yanataka60/TK-80BS_SD/JPEG/PIN1.JPG

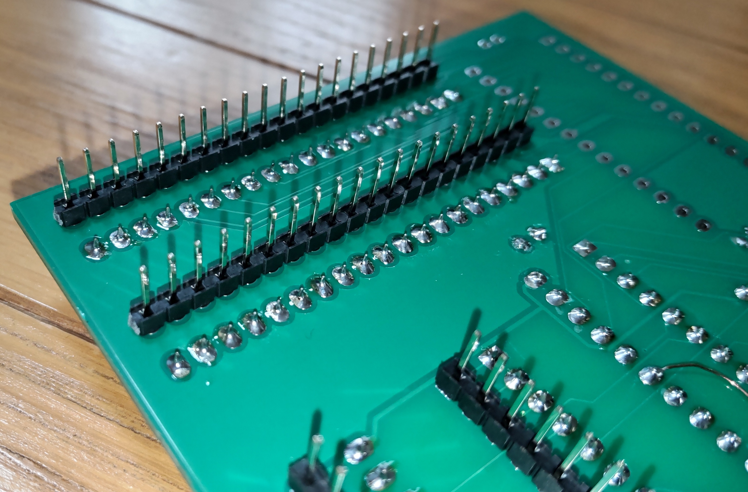
JPEG/PIN1.JPG
