yanataka60/TK-80BS_SD/JPEG/PIN2.JPG

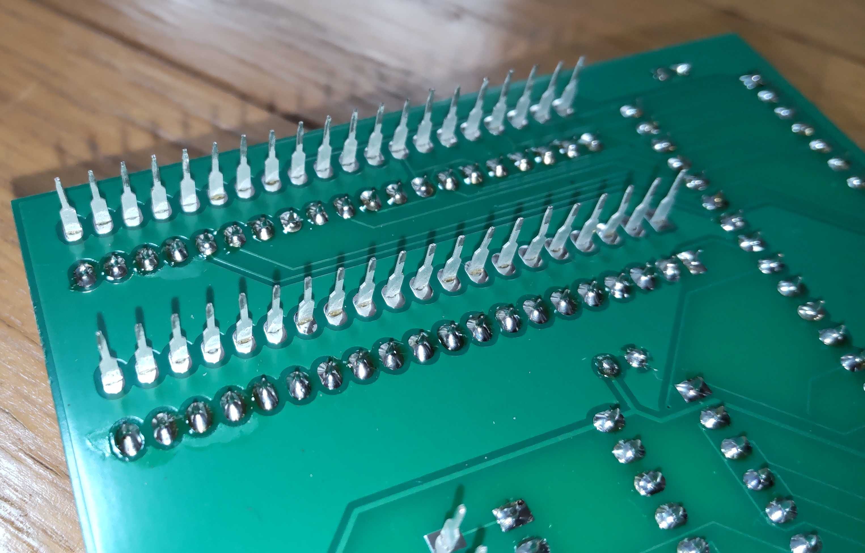
JPEG/PIN2.JPG
