yanataka60/TK-80BS_SD/JPEG/ROM2732.JPG

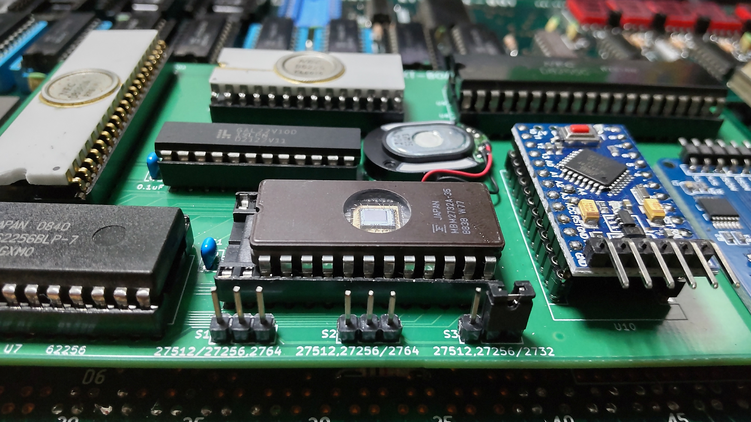
JPEG/ROM2732.JPG
