yanataka60/TK-80BS_SD/JPEG/ROM2764.JPG

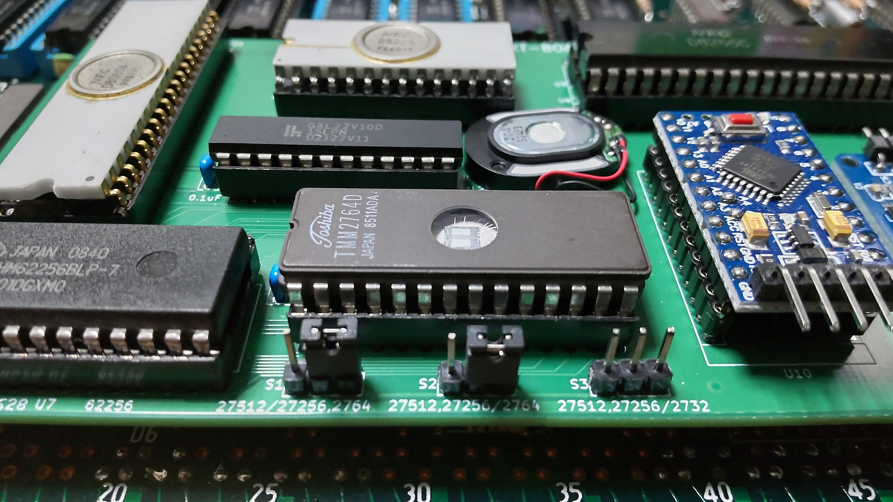
JPEG/ROM2764.JPG
