yanataka60/TK-80BS_SD/JPEG/ROM27256.JPG

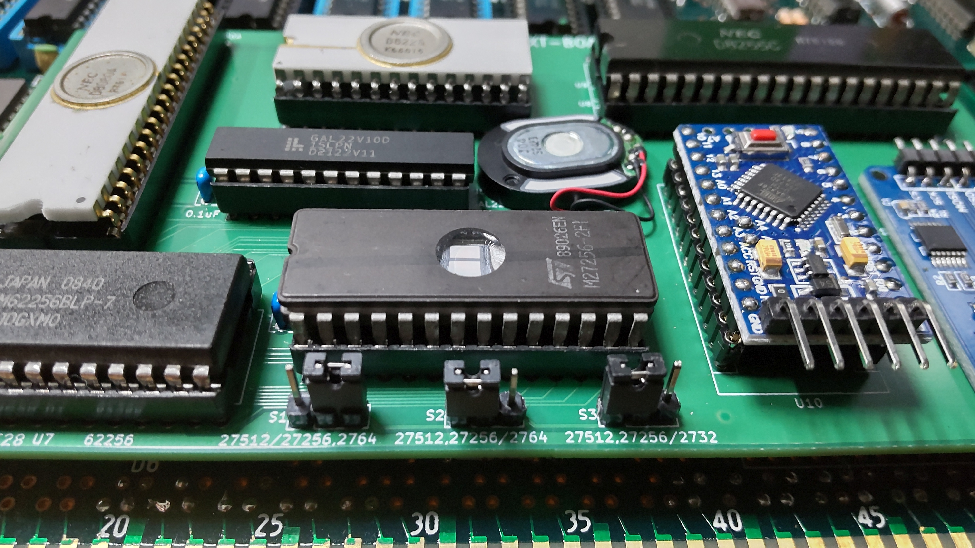
JPEG/ROM27256.JPG
