yanataka60/TK-80BS_SD/JPEG/TK-80_EXT-BOARD.JPG

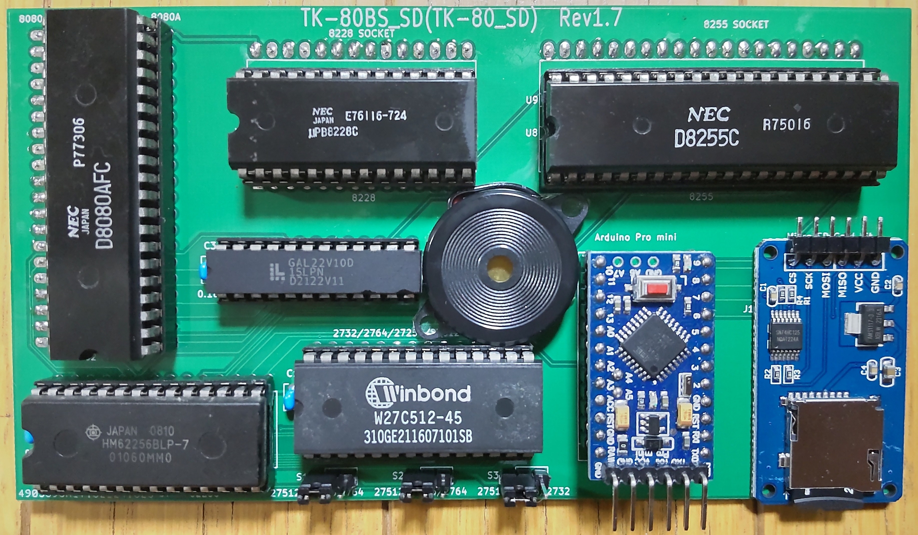
JPEG/TK-80_EXT-BOARD.JPG
