yanataka60/TK-80BS_SD/JPEG/TK-80BS_SD.JPG

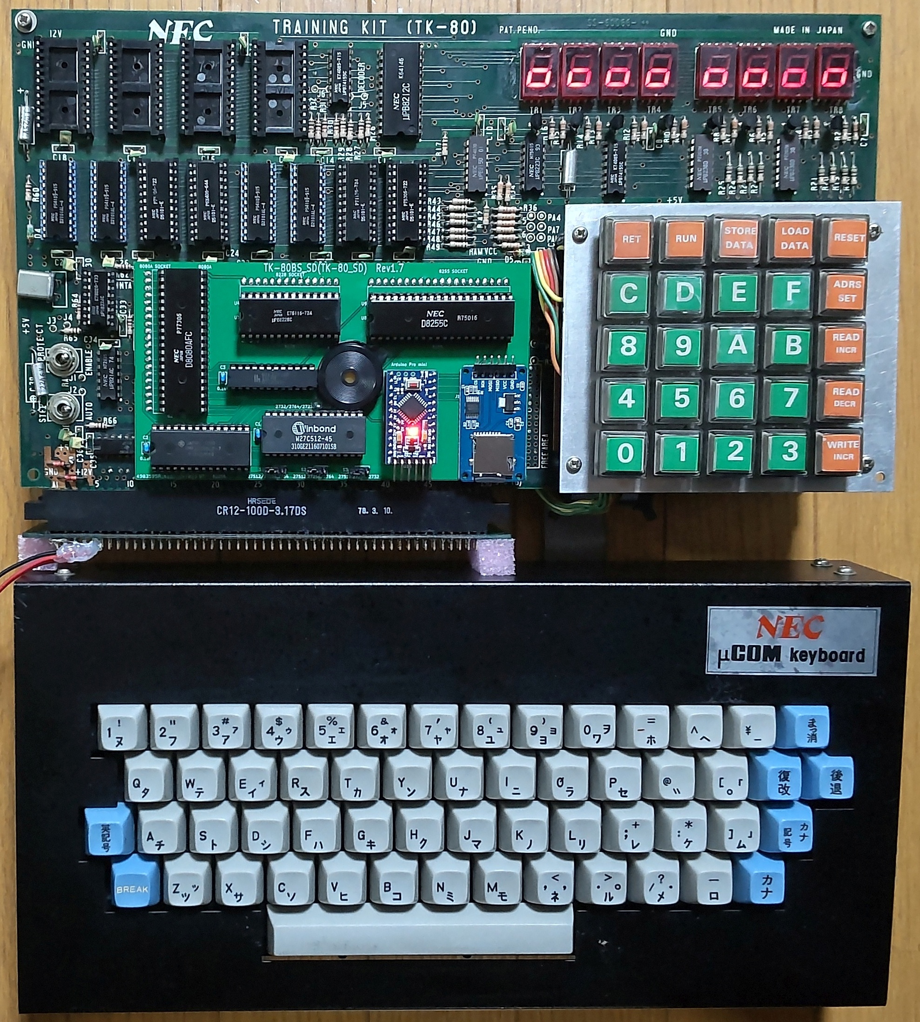
JPEG/TK-80BS_SD.JPG
