yanataka60/TK-80BS_SD/KiCad/TK-80_EXT-BOARD.pdf

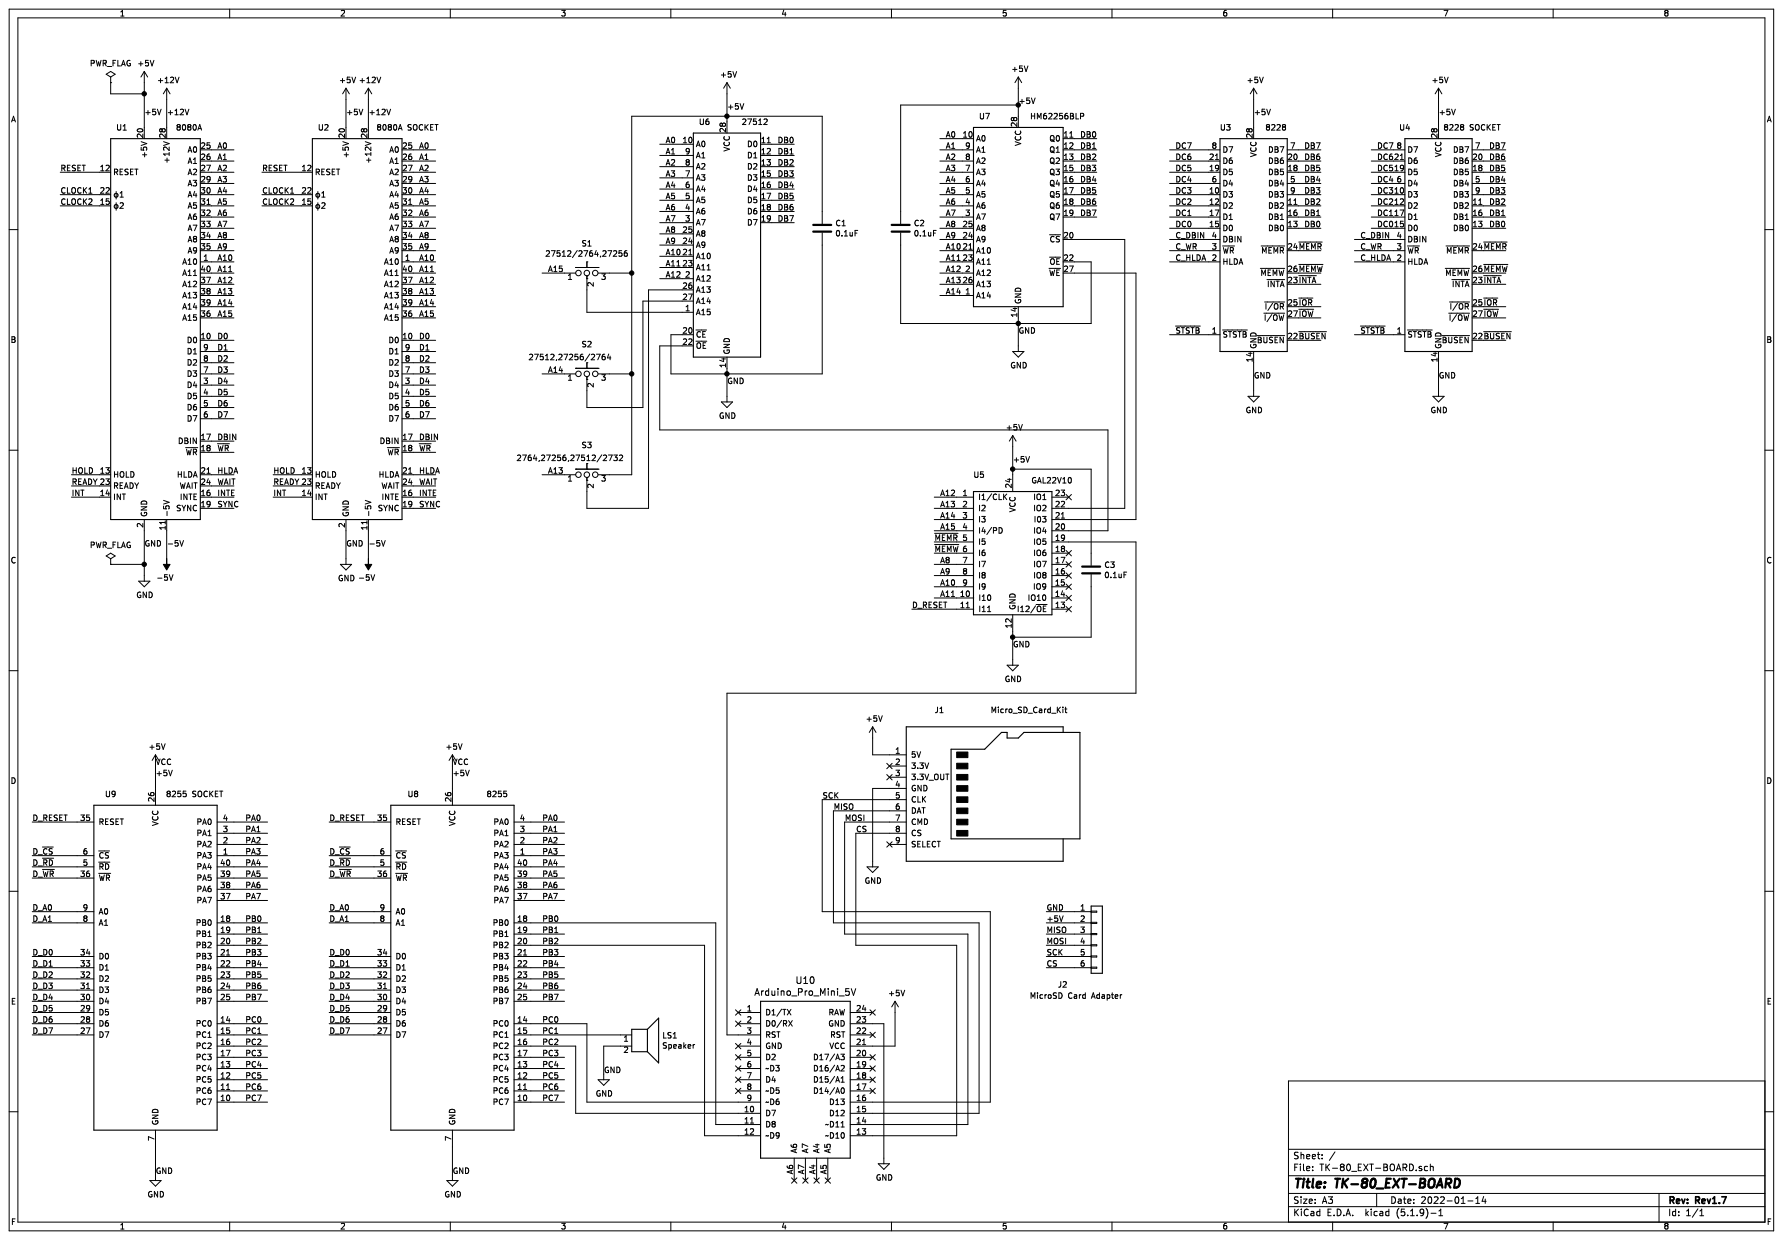
[picture p14: page 1]
