yanataka60/TK-80BS_SD/(list of files, drawings)

Other design files:
KiCad/TK-80_EXT-BOARD.dsn
