yanataka60/TK-80BS_SD/KiCad/TK-80_EXT-BOARD.kicad_pcb

## KiCad design KiCad/TK-80_EXT-BOARD.kicad_pcb (2024-10-25)

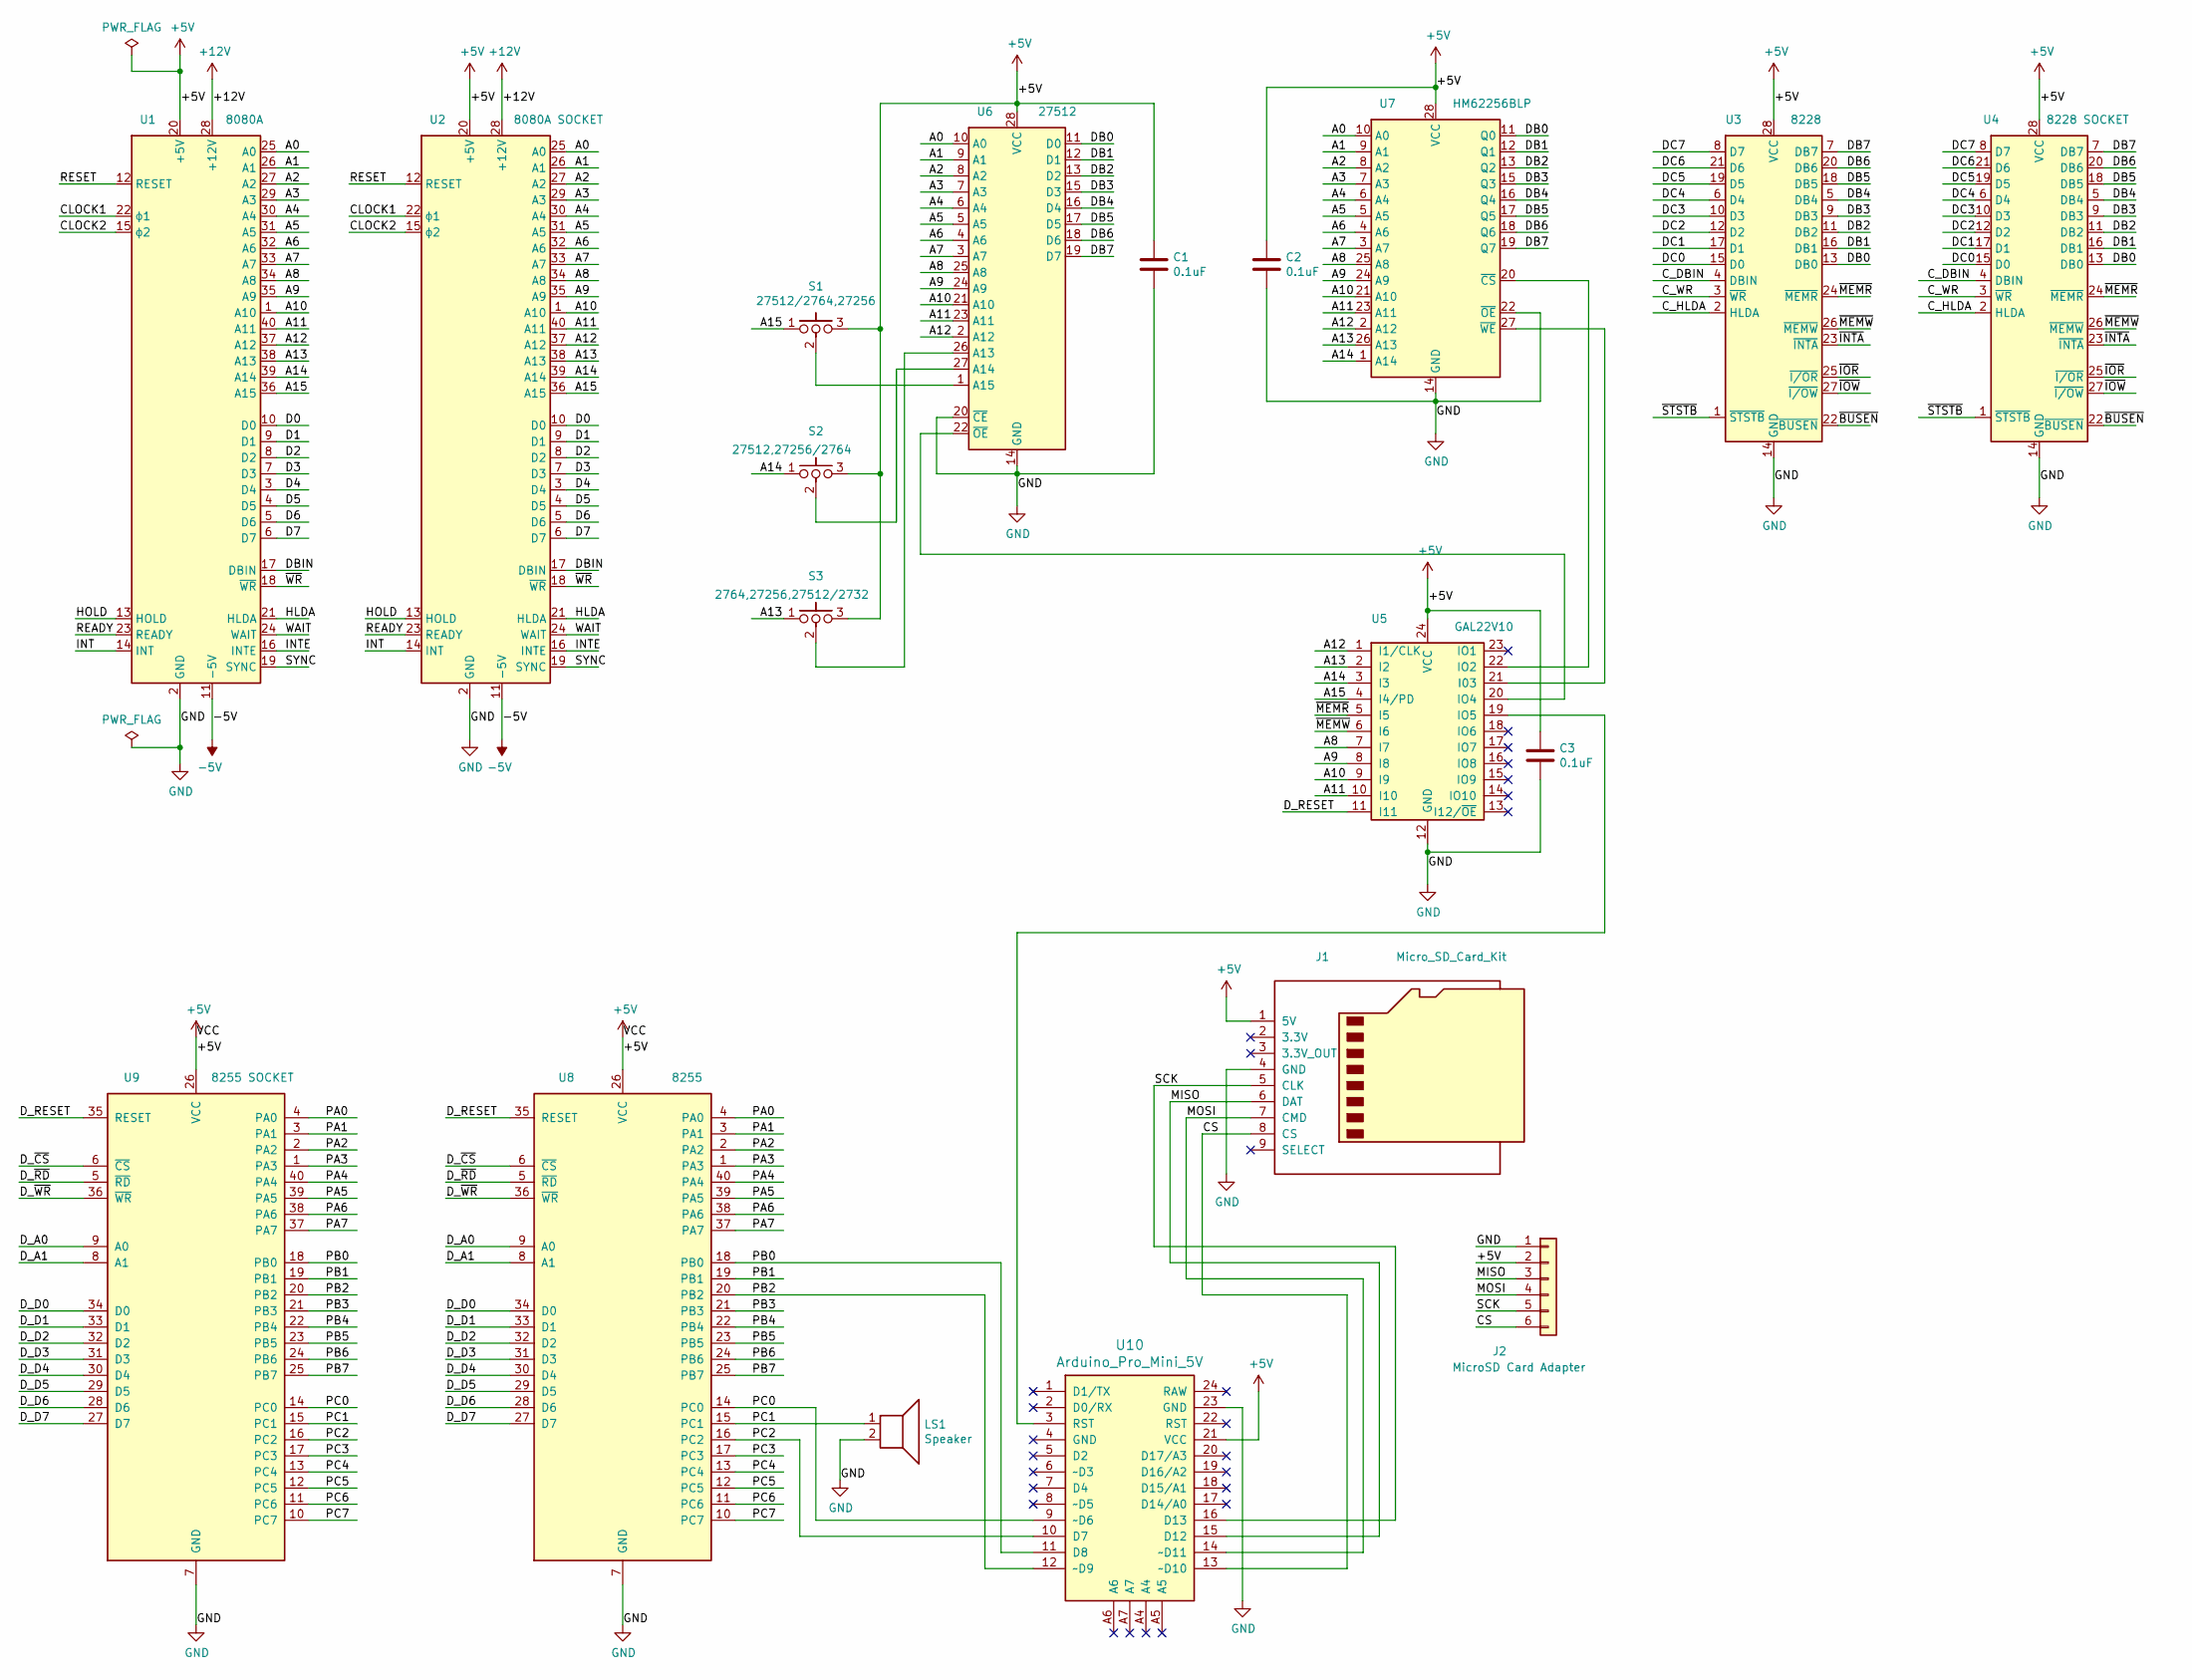
[picture p15: schematic TK-80_EXT-BOARD.sch]

Parts:
C1, C2, C3: 0.1uF; C_Rect_L4.0mm_W2.5mm_P2.50mm
J1: Micro_SD_Card_Kit; AE-microSD-LLCNV
J2: MicroSD Card Adapter; PinSocket_1x06_P2.54mm_Vertical
LS1: Speaker; PinHeader_1x02_P2.54mm_Vertical
S1: 27512/2764,27256; PinHeader_1x03_P2.54mm_Vertical
S2: 27512,27256/2764; PinHeader_1x03_P2.54mm_Vertical
S3: 2764,27256,27512/2732; PinHeader_1x03_P2.54mm_Vertical
U1: 8080A; DIP-40_W15.24mm_LongPads
U2: 8080A SOCKET; DIP-40_W15.24mm_LongPads
U3: 8228; DIP-28_W15.24mm_LongPads
U4: 8228 SOCKET; DIP-28_W15.24mm_LongPads
U5: GAL22V10; DIP-24_W7.62mm_LongPads
U6: 27512; DIP-28_W15.24mm_LongPads
U7: HM62256BLP; DIP-28_W15.24mm_LongPads
U8: 8255; DIP-40_W15.24mm_LongPads
U9: 8255 SOCKET; DIP-40_W15.24mm_LongPads
U10: Arduino_Pro_Mini_5V; Arduino_Pro_Mini

Connections:
+5V: C1.1, C2.1, C3.1, J1.1 (5V), J2.2, S1.3, S2.3, S3.3, U1.20 (+5V), U2.20 (+5V), U3.28 (VCC), U4.28 (VCC), U5.24 (VCC), U6.28 (VCC), U7.28 (VCC), U8.26 (VCC), U9.26 (VCC), U10.21 (VCC)
+12V: U1.28 (+12V), U2.28 (+12V)
-5V: U1.11 (-5V), U2.11 (-5V)
/A0: U1.25 (A0), U2.25 (A0), U6.10 (A0), U7.10 (A0)
/A1: U1.26 (A1), U2.26 (A1), U6.9 (A1), U7.9 (A1)
/A2: U1.27 (A2), U2.27 (A2), U6.8 (A2), U7.8 (A2)
/A3: U1.29 (A3), U2.29 (A3), U6.7 (A3), U7.7 (A3)
/A4: U1.30 (A4), U2.30 (A4), U6.6 (A4), U7.6 (A4)
/A5: U1.31 (A5), U2.31 (A5), U6.5 (A5), U7.5 (A5)
/A6: U1.32 (A6), U2.32 (A6), U6.4 (A6), U7.4 (A6)
/A7: U1.33 (A7), U2.33 (A7), U6.3 (A7), U7.3 (A7)
/A8: U1.34 (A8), U2.34 (A8), U5.7 (I7), U6.25 (A8), U7.25 (A8)
/A9: U1.35 (A9), U2.35 (A9), U5.8 (I8), U6.24 (A9), U7.24 (A9)
/A10: U1.1 (A10), U2.1 (A10), U5.9 (I9), U6.21 (A10), U7.21 (A10)
/A11: U1.40 (A11), U2.40 (A11), U5.10 (I10), U6.23 (A11), U7.23 (A11)
/A12: U1.37 (A12), U2.37 (A12), U5.1 (I1/CLK), U6.2 (A12), U7.2 (A12)
/A13: S3.1, U1.38 (A13), U2.38 (A13), U5.2 (I2), U7.26 (A13)
/A14: S2.1, U1.39 (A14), U2.39 (A14), U5.3 (I3), U7.1 (A14)
/A15: S1.1, U1.36 (A15), U2.36 (A15), U5.4 (I4/PD)
/CLOCK1: U1.22 (ϕ1), U2.22 (ϕ1)
/CLOCK2: U1.15 (ϕ2), U2.15 (ϕ2)
/CS: J1.8 (CS), J2.6, U10.13 (~~D10)
/C_DBIN: U3.4 (DBIN), U4.4 (DBIN)
/C_HLDA: U3.2 (HLDA), U4.2 (HLDA)
/C_WR: U3.3 (~WR), U4.3 (~WR)
/D0: U1.10 (D0), U2.10 (D0)
/D1: U1.9 (D1), U2.9 (D1)
/D2: U1.8 (D2), U2.8 (D2)
/D3: U1.7 (D3), U2.7 (D3)
/D4: U1.3 (D4), U2.3 (D4)
/D5: U1.4 (D5), U2.4 (D5)
/D6: U1.5 (D6), U2.5 (D6)
/D7: U1.6 (D7), U2.6 (D7)
/DB0: U3.13 (DB0), U4.13 (DB0), U6.11 (D0), U7.11 (Q0)
/DB1: U3.16 (DB1), U4.16 (DB1), U6.12 (D1), U7.12 (Q1)
/DB2: U3.11 (DB2), U4.11 (DB2), U6.13 (D2), U7.13 (Q2)
/DB3: U3.9 (DB3), U4.9 (DB3), U6.15 (D3), U7.15 (Q3)
/DB4: U3.5 (DB4), U4.5 (DB4), U6.16 (D4), U7.16 (Q4)
/DB5: U3.18 (DB5), U4.18 (DB5), U6.17 (D5), U7.17 (Q5)
/DB6: U3.20 (DB6), U4.20 (DB6), U6.18 (D6), U7.18 (Q6)
/DB7: U3.7 (DB7), U4.7 (DB7), U6.19 (D7), U7.19 (Q7)
/DBIN: U1.17 (DBIN), U2.17 (DBIN)
/DC0: U3.15 (D0), U4.15 (D0)
/DC1: U3.17 (D1), U4.17 (D1)
/DC2: U3.12 (D2), U4.12 (D2)
/DC3: U3.10 (D3), U4.10 (D3)
/DC4: U3.6 (D4), U4.6 (D4)
/DC5: U3.19 (D5), U4.19 (D5)
/DC6: U3.21 (D6), U4.21 (D6)
/DC7: U3.8 (D7), U4.8 (D7)
/D_A0: U8.9 (A0), U9.9 (A0)
/D_A1: U8.8 (A1), U9.8 (A1)
/D_D0: U8.34 (D0), U9.34 (D0)
/D_D1: U8.33 (D1), U9.33 (D1)
/D_D2: U8.32 (D2), U9.32 (D2)
/D_D3: U8.31 (D3), U9.31 (D3)
/D_D4: U8.30 (D4), U9.30 (D4)
/D_D5: U8.29 (D5), U9.29 (D5)
/D_D6: U8.28 (D6), U9.28 (D6)
/D_D7: U8.27 (D7), U9.27 (D7)
/D_RESET: U5.11 (I11), U8.35 (RESET), U9.35 (RESET)
/D_~CS: U8.6 (~CS~), U9.6 (~CS~)
/D_~RD: U8.5 (~RD~), U9.5 (~RD~)
/D_~WR: U8.36 (~WR~), U9.36 (~WR~)
/HLDA: U1.21 (HLDA), U2.21 (HLDA)
/HOLD: U1.13 (HOLD), U2.13 (HOLD)
/INT: U1.14 (INT), U2.14 (INT)
/INTE: U1.16 (INTE), U2.16 (INTE)
/MISO: J1.6 (DAT), J2.3, U10.15 (D12)
/MOSI: J1.7 (CMD), J2.4, U10.14 (~~D11)
/PA0: U8.4 (PA0), U9.4 (PA0)
/PA1: U8.3 (PA1), U9.3 (PA1)
/PA2: U8.2 (PA2), U9.2 (PA2)
/PA3: U8.1 (PA3), U9.1 (PA3)
/PA4: U8.40 (PA4), U9.40 (PA4)
/PA5: U8.39 (PA5), U9.39 (PA5)
/PA6: U8.38 (PA6), U9.38 (PA6)
/PA7: U8.37 (PA7), U9.37 (PA7)
/PB0: U8.18 (PB0), U9.18 (PB0), U10.11 (D8)
/PB1: U8.19 (PB1), U9.19 (PB1)
/PB2: U8.20 (PB2), U9.20 (PB2), U10.12 (~~D9)
/PB3: U8.21 (PB3), U9.21 (PB3)
/PB4: U8.22 (PB4), U9.22 (PB4)
/PB5: U8.23 (PB5), U9.23 (PB5)
/PB6: U8.24 (PB6), U9.24 (PB6)
/PB7: U8.25 (PB7), U9.25 (PB7)
/PC0: U8.14 (PC0), U9.14 (PC0), U10.9 (~~D6)
/PC1: LS1.1, U8.15 (PC1), U9.15 (PC1)
/PC2: U8.16 (PC2), U9.16 (PC2), U10.10 (D7)
/PC3: U8.17 (PC3), U9.17 (PC3)
/PC4: U8.13 (PC4), U9.13 (PC4)
/PC5: U8.12 (PC5), U9.12 (PC5)
/PC6: U8.11 (PC6), U9.11 (PC6)
/PC7: U8.10 (PC7), U9.10 (PC7)
/READY: U1.23 (READY), U2.23 (READY)
/RESET: U1.12 (RESET), U2.12 (RESET)
/SCK: J1.5 (CLK), J2.5, U10.16 (D13)
/SYNC: U1.19 (SYNC), U2.19 (SYNC)
/WAIT: U1.24 (WAIT), U2.24 (WAIT)
/~BUSEN: U3.22 (~BUSEN), U4.22 (~BUSEN)
/~INTA: U3.23 (~INTA), U4.23 (~INTA)
/~IOR: U3.25 (~I/OR), U4.25 (~I/OR)
/~IOW: U3.27 (~I/OW), U4.27 (~I/OW)
/~MEMR: U3.24 (~MEMR), U4.24 (~MEMR), U5.5 (I5)
/~MEMW: U3.26 (~MEMW), U4.26 (~MEMW), U5.6 (I6)
/~STSTB: U3.1 (~STSTB), U4.1 (~STSTB)
/~WR: U1.18 (~WR~), U2.18 (~WR~)
GND: C1.2, C2.2, C3.2, J1.4 (GND), J2.1, LS1.2, U1.2 (GND), U2.2 (GND), U3.14 (GND), U4.14 (GND), U5.12 (GND), U6.14 (GND), U6.20 (~CE), U7.14 (GND), U7.22 (~OE), U8.7 (GND), U9.7 (GND), U10.23 (GND)
unnamed: S1.2, U6.1 (A15)
unnamed: S2.2, U6.27 (A14)
unnamed: S3.2, U6.26 (A13)
unnamed: U5.20 (IO4), U6.22 (~OE)
unnamed: U5.21 (I03), U7.27 (~WE)
unnamed: U5.22 (IO2), U7.20 (~CS)
unnamed: U5.19 (IO5), U10.3 (RST)

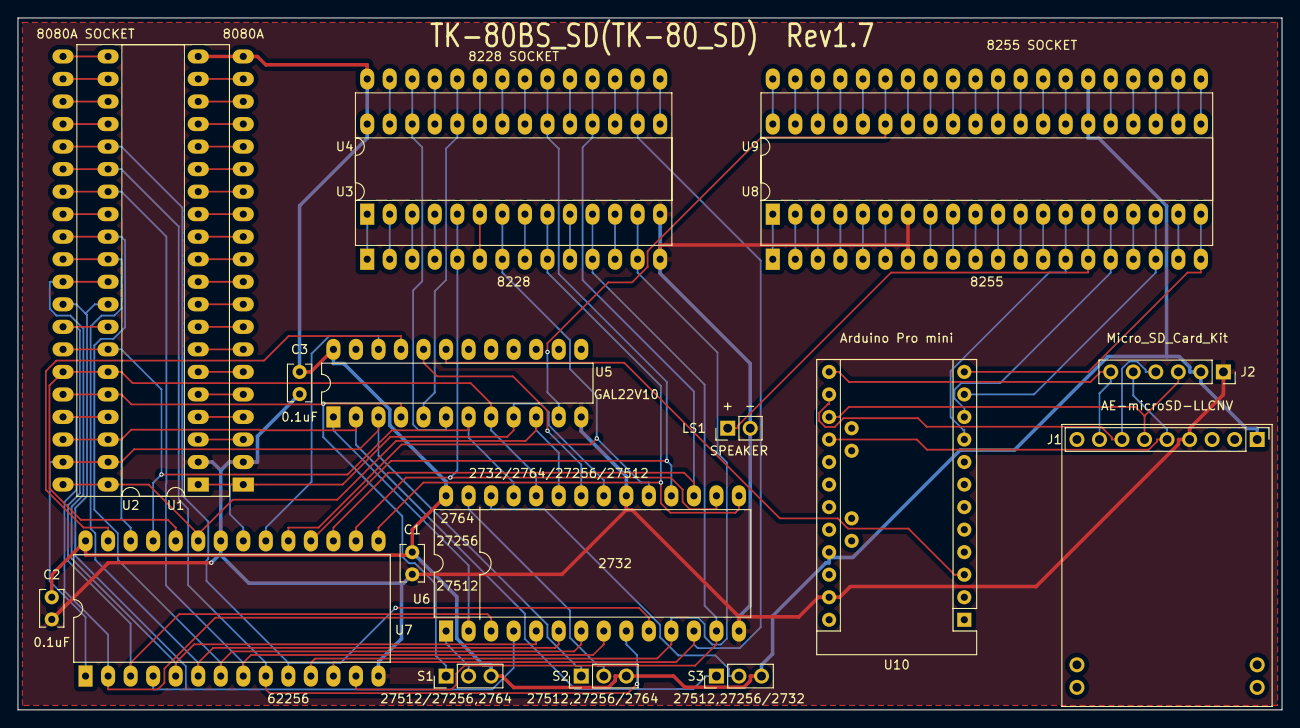
[picture p16: board TK-80_EXT-BOARD.kicad_pcb from above]

Board: 2 copper layers, 142.5 x 78.0 mm, 19 parts (0 on the bottom side), 115 nets.
